TeoField-Marsham/Embedded_Systems_Group3/images/SmartMail.png

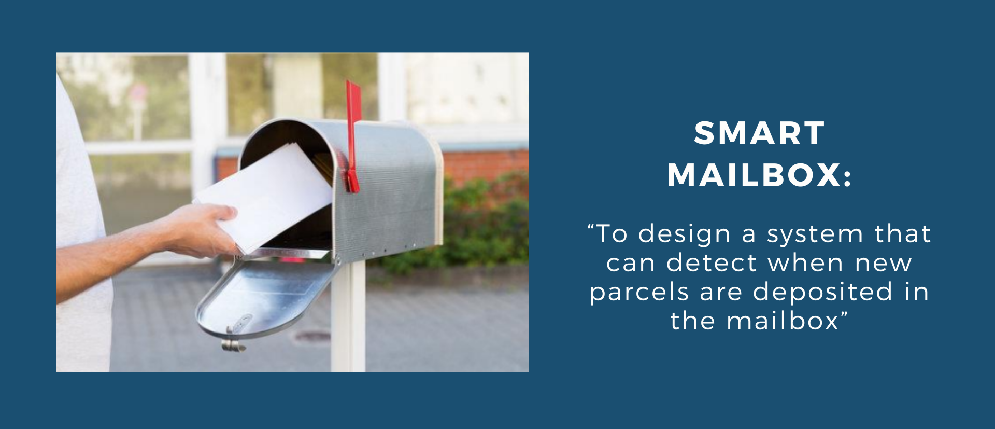
images/SmartMail.png
