TeoField-Marsham/Embedded_Systems_Group3/mailbox_module_code/lora_projectsender.ino

#include <SPI.h>
#include <LoRa.h> /* Install "LoRa" by Sandeep Mistry */

// SPI/LoRa pins for LilyGO T3 V1.6.1
#define SCK 5
#define MISO 19
#define MOSI 27
#define SS 18
#define RST 14
#define DIO0 26

#define RESET_PIN 22
#define MOTION_PIN 19

#define BAND 915E6

bool resetPressed = false;
bool motionDetected = false;

int lastResetTime = 0;
int lastMotionTime = 0;

// Interrupt service for reset button
void IRAM_ATTR handleReset() {
  unsigned long now = millis();
  // Only trigger if more than 3 seconds have passed since last reset
  if (now - lastResetTime > 3000) {
    resetPressed = true;
    lastResetTime = now;
  }
}

// Interrupt service for motion sensor
void IRAM_ATTR handleMotion() {
  unsigned long now = millis();
  // Only trigger if more than 5 seconds have passed since last detection
  if (now - lastMotionTime > 5000) {
    motionDetected = true;
    lastMotionTime = now;
  }
}

void setup() {
  Serial.begin(115200);
  while (!Serial);

  // Configure LoRa pins
  SPI.begin(SCK, MISO, MOSI, SS);
  LoRa.setPins(SS, RST, DIO0);

  if (!LoRa.begin(BAND)) {
    Serial.println("Fail to start LoRa!");
    while (1);
  }

  Serial.println("LoRa successfully initiated!");

  attachInterrupt(digitalPinToInterrupt(RESET_PIN), handleReset, FALLING);
  attachInterrupt(digitalPinToInterrupt(MOTION_PIN), handleMotion, RISING);
}

void loop() {
  // Reset button logic
  if (resetPressed){
    Serial.println("Sending: reset");
    LoRa.beginPacket();
    LoRa.print("reset");
    LoRa.endPacket();

    resetPressed = false;

    delay(5000);  // Interval between resets
  } else if (motionDetected){
    delay(15000); // Waits 5 seconds to see if the reset button won't be pressed
    if (!resetPressed){
      Serial.println("Sending: newmail");
      LoRa.beginPacket();
      LoRa.print("newmail");
      LoRa.endPacket();

      motionDetected = false;

      delay(5000);  // Interval
    }
  }
  delay(10);
}
