TeoField-Marsham/Embedded_Systems_Group3/(commit log)

2025-05-12 you dont need that part, just check the arduino ide libraries
2025-05-13 Mail count + reset
    [lora_projectsender.ino]
